stustanet/spacelock/(list of files, cad)

Other CAD files:
mount/parametric_involute_gear_v5.0.scad
