stustanet/spacelock/board_inside/motor-current-measurements/full curve.png

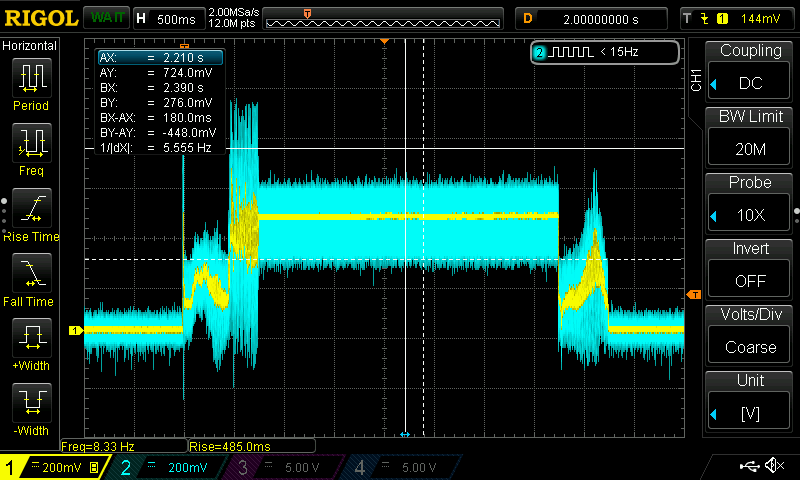
board_inside/motor-current-measurements/full curve.png
