stustanet/spacelock/board_inside/motor-current-measurements/opening.png

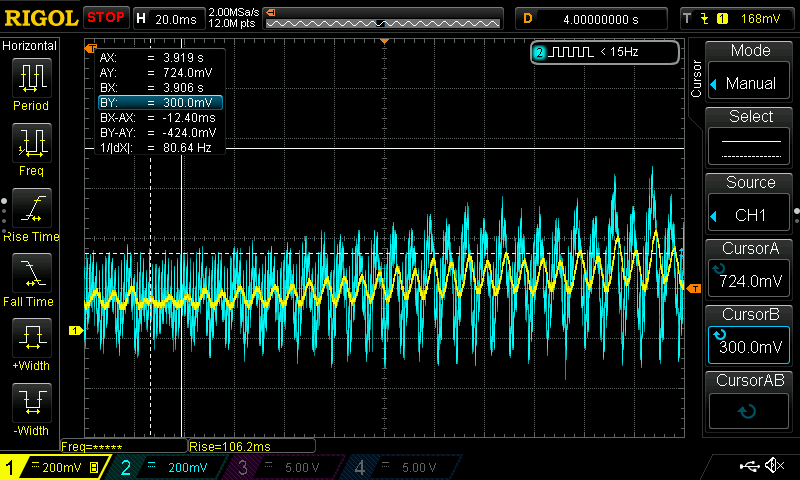
board_inside/motor-current-measurements/opening.png
