stustanet/spacelock/board_inside/motor-current-measurements/start pulse.png

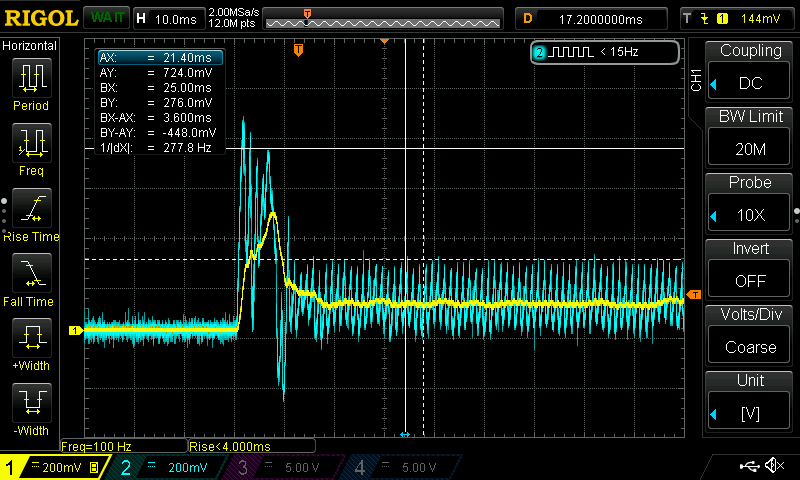
board_inside/motor-current-measurements/start pulse.png
