stustanet/spacelock/board_inside/motor-current-measurements/transition and endstop.png

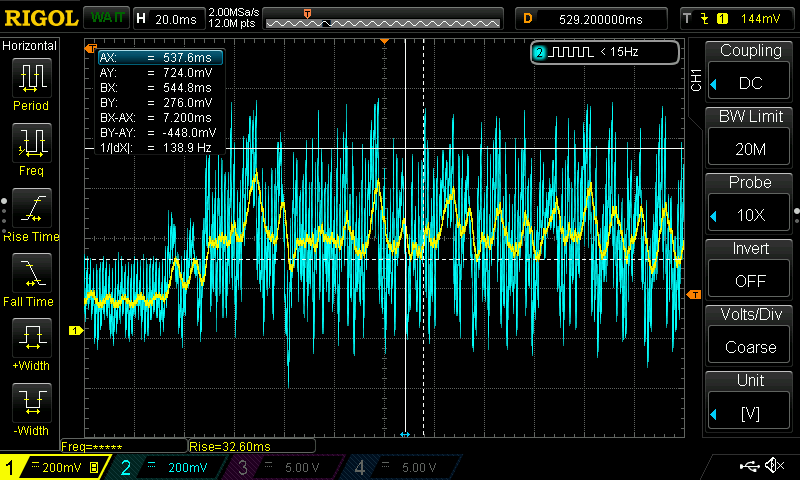
board_inside/motor-current-measurements/transition and endstop.png
