stustanet/spacelock/board_inside/board_v1.1/changes.md

# v1.0 to v1.1
- improve debug connector
- add resistor divider for Vref for motor driver
- add RTC
- add connector for QR-Reader
