stustanet/spacelock/board_inside/board_v1.1/board.kicad_pcb

## KiCad design board_inside/board_v1.1/board.kicad_pcb (2024-01-21)

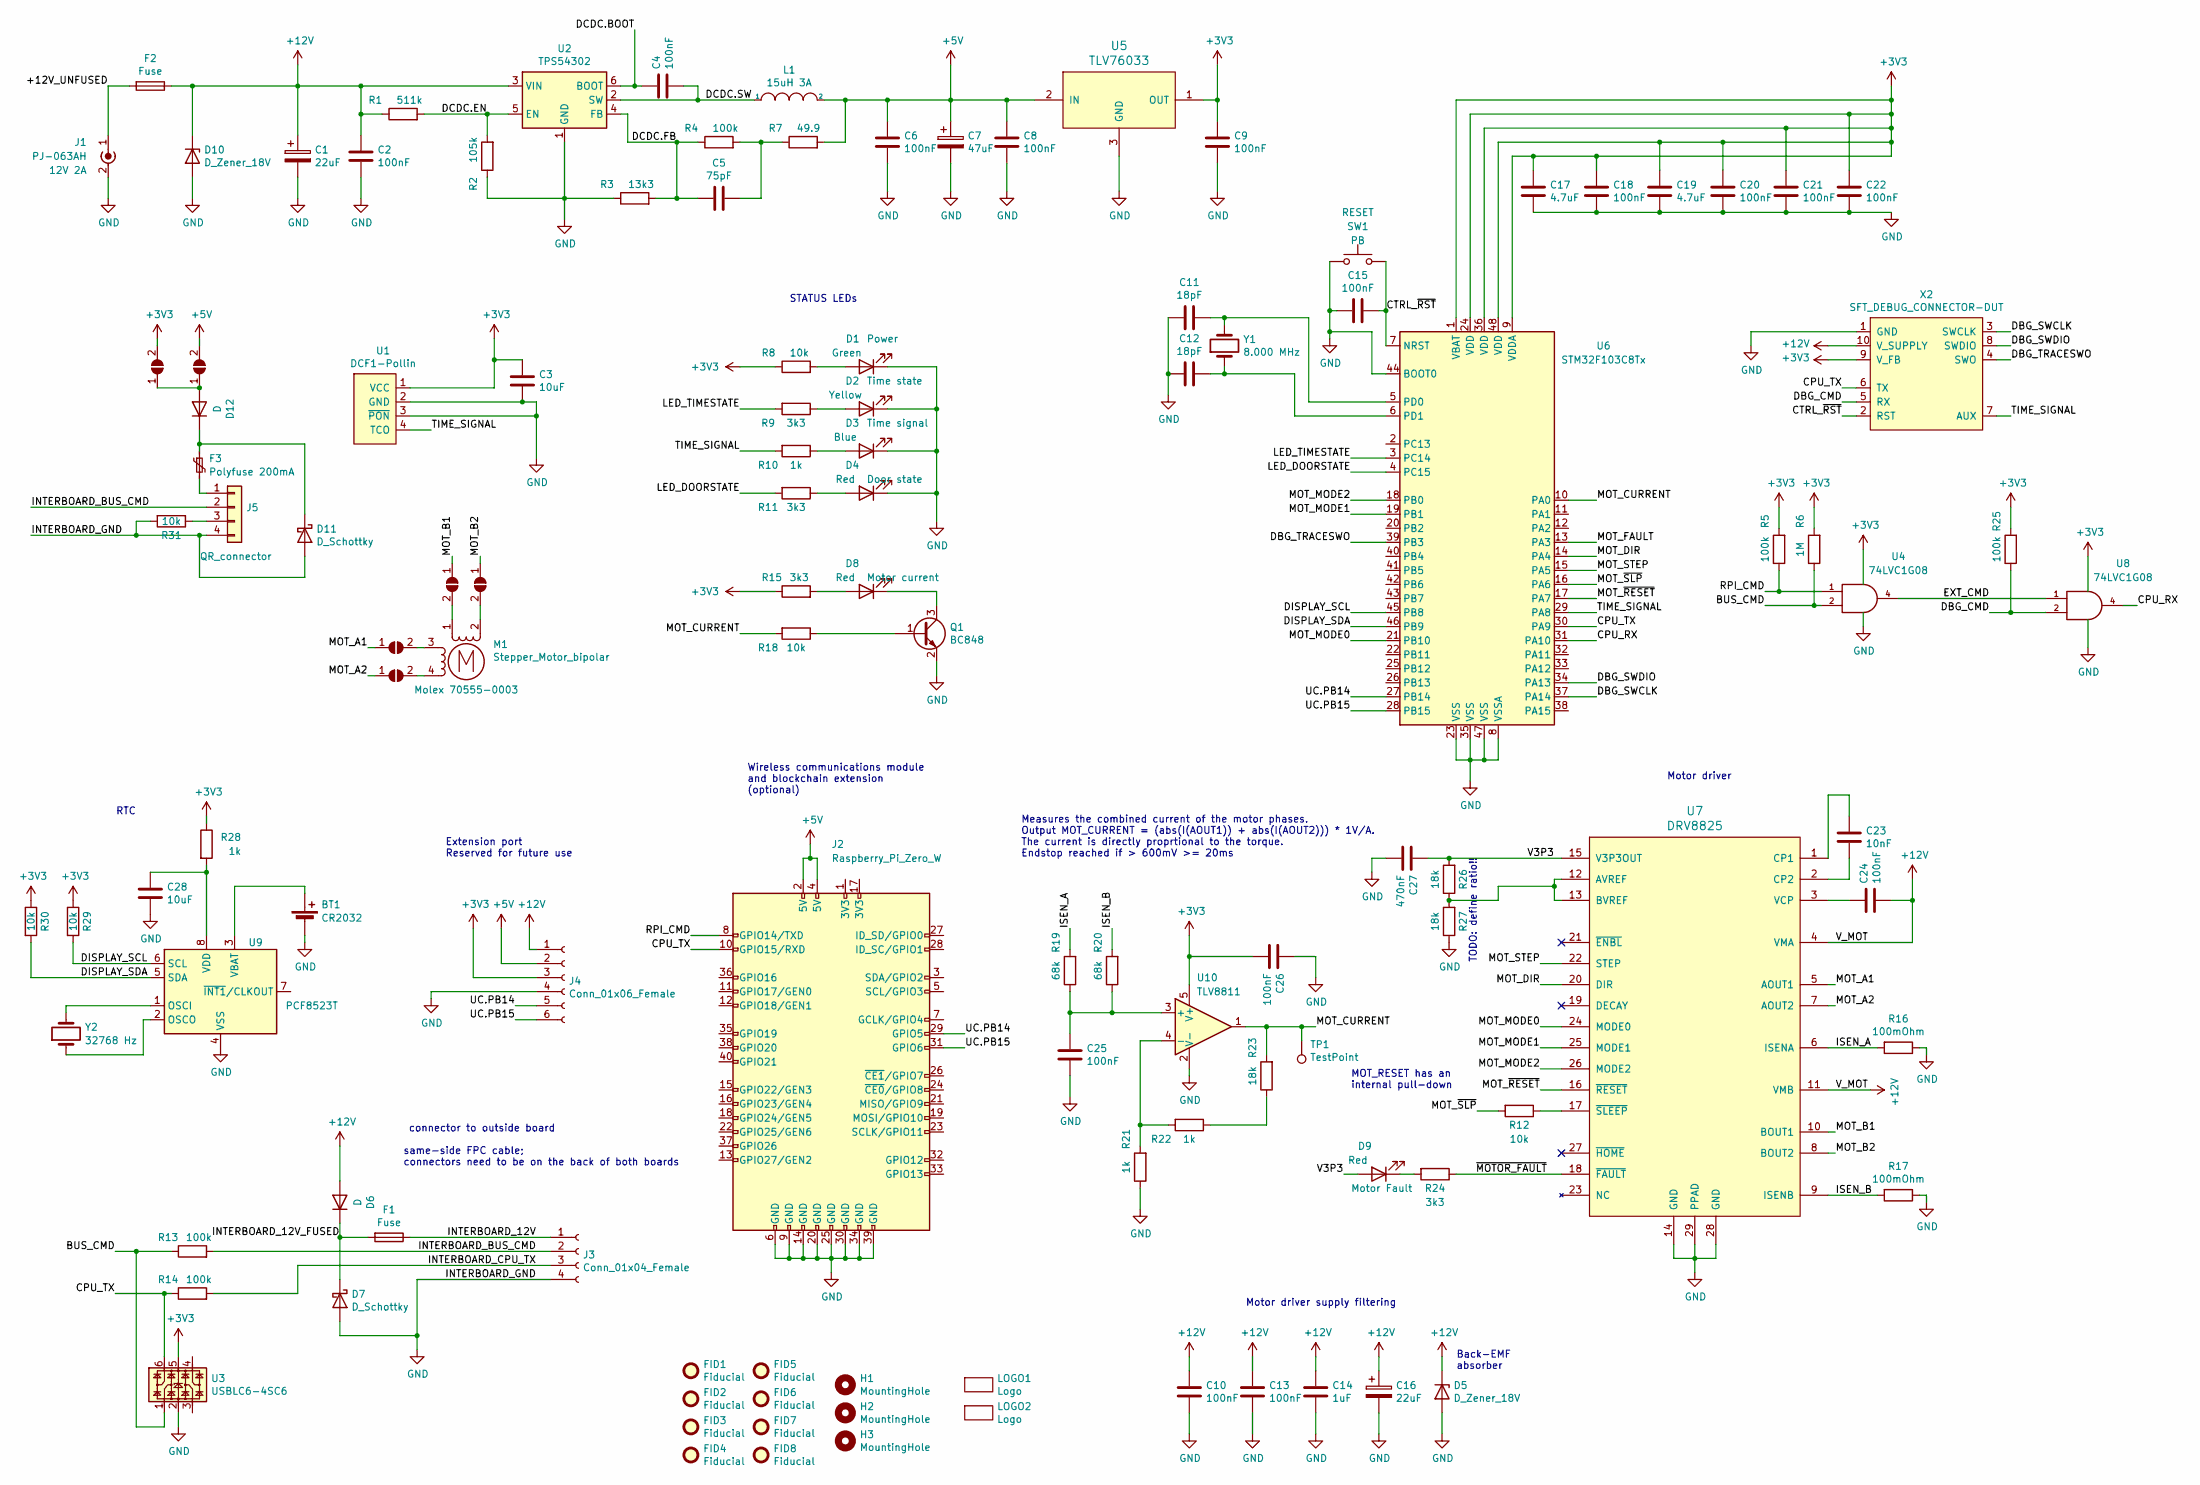
[picture p5: schematic board.kicad_sch, spacelock main board]

Parts:
BT1: CR2032; BatteryHolder_Keystone_3000_1x12mm; MPN Keystone 3000
C1, C16: 22uF; C_1206_3216Metric_Pad1.33x1.80mm_HandSolder; Rating 25V; MPN generic C%f %v %r
C2, C4, C6, C8, C9, C10, C13, C15, C18, C20, C21, C22, C24, C25, C26: 100nF; C_0603_1608Metric_Pad1.08x0.95mm_HandSolder; MPN generic C%f %v %r
C3, C28: 10uF; C_0603_1608Metric_Pad1.08x0.95mm_HandSolder; Rating 6.3V; MPN generic C%f %v %r
C5: 75pF; C_0603_1608Metric_Pad1.08x0.95mm_HandSolder; MPN generic C%f %v %r
C7: 47uF; C_1206_3216Metric_Pad1.33x1.80mm_HandSolder; Rating 6.3V; MPN generic C%f %v %r
C11, C12: 18pF; C_0603_1608Metric_Pad1.08x0.95mm_HandSolder; MPN generic C%f %v %r
C14: 1uF; C_0603_1608Metric_Pad1.08x0.95mm_HandSolder; MPN generic C%f %v %r
C17, C19: 4.7uF; C_0603_1608Metric_Pad1.08x0.95mm_HandSolder; Rating 6.3V; MPN generic C%f %v %r
C23: 10nF; C_0603_1608Metric_Pad1.08x0.95mm_HandSolder; MPN generic C%f %v %r
C27: 470nF; C_0603_1608Metric_Pad1.08x0.95mm_HandSolder; Rating 6.3V; MPN generic C%f %v %r
D1: Green; LED_0805_2012Metric_Pad1.15x1.40mm_HandSolder; MPN Wuerth 150080GS75000
D2: Yellow; LED_0805_2012Metric_Pad1.15x1.40mm_HandSolder; MPN Wuerth 150080YS75000
D3: Blue; LED_0805_2012Metric_Pad1.15x1.40mm_HandSolder; MPN Wuerth 150080BS75000
D4, D8, D9: Red; LED_0805_2012Metric_Pad1.15x1.40mm_HandSolder; MPN Wuerth 150080RS75000
D5, D10: D_Zener_18V; D_MiniMELF_Handsoldering; MPN generic ZMM5248B
D6, D12: D; D_SMB; MPN Rectron HFM208-W
D7, D11: D_Schottky; D_SOD-123; MPN Rectron 2SS100L-W
F1, F2: Fuse; Schurter-OGN-SMD; MPN Schurter OGN SMD
F3: Polyfuse 200mA; R_1210_3225Metric; MPN Littlefuse 1206L020YR
FID1, FID2, FID3, FID4, FID5, FID6, FID7, FID8: Fiducial; Fiducial_1mm_Mask2mm
H1, H2, H3: MountingHole; MountingHole_3.2mm_M3
J1: PJ-063AH; BarrelJack_CUI_PJ-063AH_Horizontal; MPN CUI PJ-063AH
J2: Raspberry_Pi_Zero_W; Raspberry_Pi_Zero_Socketed_THT_FaceDown_MountingHoles
J3: Conn_01x04_Female; Wuerth-686104188622; MPN Wuerth 686104188622
J4: Conn_01x06_Female; PinSocket_1x06_P2.54mm_Vertical
J5: QR_connector; PinHeader_1x04_P2.54mm_Vertical; MPN generic header-2.54mm
JP1, JP2, JP3, JP4, JP5, JP6: SolderJumper_2_Open; SolderJumper-2_P1.3mm_Open_TrianglePad1.0x1.5mm
L1: 15uH 3A; SRN8040TA; MPN Bourns SRN8040TA-150M
LOGO1: Logo; LOGO
LOGO2: Logo; LOGO_CU_070
M1: Stepper_Motor_bipolar; Molex-70555-0003; MPN Molex 70555-0003
Q1: BC848; SOT-23; MPN generic BC848B
R1: 511k; R_0603_1608Metric_Pad0.98x0.95mm_HandSolder; MPN generic R%f %v %r
R2: 105k; R_0603_1608Metric_Pad0.98x0.95mm_HandSolder; MPN generic R%f %v %r
R3: 13k3; R_0603_1608Metric_Pad0.98x0.95mm_HandSolder; MPN generic R%f %v %r
R4, R5, R13, R14, R25: 100k; R_0603_1608Metric_Pad0.98x0.95mm_HandSolder; MPN generic R%f %v %r
R6: 1M; R_0603_1608Metric_Pad0.98x0.95mm_HandSolder; MPN generic R%f %v %r
R7: 49.9; R_0603_1608Metric_Pad0.98x0.95mm_HandSolder; MPN generic R%f %v %r
R8, R12, R18, R29, R30, R31: 10k; R_0603_1608Metric_Pad0.98x0.95mm_HandSolder; MPN generic R%f %v %r
R9, R11, R15, R24: 3k3; R_0603_1608Metric_Pad0.98x0.95mm_HandSolder; MPN generic R%f %v %r
R10, R21, R22, R28: 1k; R_0603_1608Metric_Pad0.98x0.95mm_HandSolder; MPN generic R%f %v %r
R16, R17: 100mOhm; R_2512_6332Metric; MPN Yageo PT2512FK-7W0R1L
R19, R20: 68k; R_0603_1608Metric_Pad0.98x0.95mm_HandSolder; MPN generic R%f %v %r
R23, R26, R27: 18k; R_0603_1608Metric_Pad0.98x0.95mm_HandSolder; MPN generic R%f %v %r
SW1: PB; SW_PUSH_6mm_H4.3mm; MPN Panasonic EVQPAE05R
TP1: TestPoint; TestPoint_Pad_D1.5mm
U1: DCF1-Pollin; MPN Pollin DCF1
U2: TPS54302; SOT-23-6; MPN TI TPS54302DDC
U3: USBLC6-4SC6; SOT-23-6; MPN ST USBLC6-4SC6
U4, U8: 74LVC1G08; SOT-23-5_HandSoldering; MPN TI 74LVC1G08DBV
U5: TLV76033; SOT-23; MPN TI TLV76033DBZ
U6: STM32F103C8Tx; LQFP-48_7x7mm_P0.5mm; MPN ST STM32F103C8T6
U7: DRV8825; HTSSOP-28-1EP_4.4x9.7mm_P0.65mm_EP3.4x9.5mm_ThermalVias; MPN TI DRV8825PWP
U9: PCF8523T; SOIC-8_3.9x4.9mm_P1.27mm; MPN NXP PCF8523T
U10: TLV8811; SOT-23-5_HandSoldering; MPN TI TLV8811DBV
X2: SFT_DEBUG_CONNECTOR-DUT; Tag-Connect_TC2050-IDC-FP_2x05_P1.27mm_Vertical
Y1: 8.000 MHz; Crystal_HC49-U_Vertical; MPN ZheJiang B08000J065
Y2: 32768 Hz; Crystal_SMD_EuroQuartz_EQ161-2Pin_3.2x1.5mm_HandSoldering; MPN MicroCrystal CM7V-T1A-LOW-ESR-32.768KHZ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

Connections:
+3V3: C3.1, C9.1, C17.1, C18.1, C19.1, C20.1, C21.1, C22.1, C26.2, J4.3, JP6.2 (B), R5.2, R6.2, R8.1, R15.1, R25.2, R28.1, R29.1, R30.1, U1.1 (VCC), U3.5, U4.5 (VCC), U5.1 (OUT), U6.1 (VBAT), U6.9 (VDDA), U6.24 (VDD), U6.36 (VDD), U6.48 (VDD), U8.5 (VCC), U10.5 (V+), X2.9 (V_FB)
+5V: C6.1, C7.1, C8.1, J2.2 (5V), J2.4 (5V), J4.2, JP5.2 (B), L1.2, R7.2, U5.2 (IN)
+12V: C1.1, C2.1, C10.1, C13.1, C14.1, C16.1, C24.2, D5.1 (K), D6.2 (A), D10.1 (K), F2.1, J4.1, R1.1, U2.3 (VIN), U7.4 (VMA), U7.11 (VMB), X2.10 (V_SUPPLY)
/+12V_UNFUSED: F2.2, J1.1 (In)
/BUS_CMD: R6.1, R13.1, U3.1, U4.2
/CPU_RX: U6.31 (PA10), U8.4
/CPU_TX: J2.10 (GPIO15/RXD), R14.1, U3.6, U6.30 (PA9), X2.6 (TX)
/CTRL_~RST: C15.1, SW1.2, U6.7 (NRST), X2.2 (RST)
/DBG_CMD: R25.1, U8.2, X2.5 (RX)
/DBG_SWCLK: U6.37 (PA14), X2.3 (SWCLK)
/DBG_SWDIO: U6.34 (PA13), X2.8 (SWDIO)
/DBG_TRACESWO: U6.39 (PB3), X2.4 (SWO)
/DCDC.BOOT: C4.1, U2.6 (BOOT)
/DCDC.EN: R1.2, R2.2, U2.5 (EN)
/DCDC.FB: C5.2, R3.2, R4.1, U2.4 (FB)
/DCDC.SW: C4.2, L1.1, U2.2 (SW)
/DISPLAY_SCL: R29.2, U6.45 (PB8), U9.6 (SCL)
/DISPLAY_SDA: R30.2, U6.46 (PB9), U9.5 (SDA)
/EXT_CMD: U4.4, U8.1
/INTERBOARD_12V: F1.1, J3.1
/INTERBOARD_12V_FUSED: D6.1 (K), D7.1 (K), F1.2
/INTERBOARD_BUS_CMD: J3.2, J5.2, R13.2
/INTERBOARD_CPU_TX: J3.3, R14.2
/ISEN_A: R16.2, R19.2, U7.6 (ISENA)
/ISEN_B: R17.2, R20.2, U7.9 (ISENB)
/LED_DOORSTATE: R11.2, U6.4 (PC15)
/LED_TIMESTATE: R9.2, U6.3 (PC14)
/MOT_A1: JP1.1 (A), U7.5 (AOUT1)
/MOT_A2: JP2.1 (A), U7.7 (AOUT2)
/MOT_B1: JP3.1 (A), U7.10 (BOUT1)
/MOT_B2: JP4.1 (A), U7.8 (BOUT2)
/MOT_CURRENT: R18.2, R23.2, TP1.1, U6.10 (PA0), U10.1
/MOT_DIR: U6.14 (PA4), U7.20 (DIR)
/MOT_FAULT: U6.13 (PA3)
/MOT_MODE0: U6.21 (PB10), U7.24 (MODE0)
/MOT_MODE1: U6.19 (PB1), U7.25 (MODE1)
/MOT_MODE2: U6.18 (PB0), U7.26 (MODE2)
/MOT_STEP: U6.15 (PA5), U7.22 (STEP)
/MOT_~RESET: U6.17 (PA7), U7.16 (~RESET)
/MOT_~SLP: R12.2, U6.16 (PA6)
/RPI_CMD: J2.8 (GPIO14/TXD), R5.1, U4.1
/TIME_SIGNAL: R10.2, U1.4 (TCO), U6.29 (PA8), X2.7 (AUX)
/UC.PB14: J2.29 (GPIO5), J4.5, U6.27 (PB14)
/UC.PB15: J2.31 (GPIO6), J4.6, U6.28 (PB15)
/V3P3: C27.1, D9.2 (A), R26.2, U7.15 (V3P3OUT)
/~MOTOR_FAULT: R24.1, U7.18 (~FAULT)
GND: BT1.2 (-), C1.2, C2.2, C3.2, C6.2, C7.2, C8.2, C9.2, C10.2, C11.2, C12.2, C13.2, C14.2, C15.2, C16.2, C17.2, C18.2, C19.2, C20.2, C21.2, C22.2, C25.2, C26.1, C27.2, C28.2, D1.1 (K), D2.1 (K), D3.1 (K), D4.1 (K), D5.2 (A), D7.2 (A), D10.2 (A), D11.2 (A), J1.2 (Ext), J2.6 (GND), J2.9 (GND), J2.14 (GND), J2.20 (GND), J2.25 (GND), J2.30 (GND), J2.34 (GND), J2.39 (GND), J3.4, J4.4, J5.4, Q1.2 (E), R2.1, R3.1, R16.1, R17.1, R21.1, R27.1, R31.2, SW1.1, U1.2 (GND), U1.3 (~PON), U2.1 (GND), U3.2, U4.3 (GND), U5.3 (GND), U6.8 (VSSA), U6.23 (VSS), U6.35 (VSS), U6.44 (BOOT0), U6.47 (VSS), U7.14 (GND), U7.28 (GND), U7.29 (PPAD), U8.3 (GND), U9.4 (VSS), U10.2 (V-), X2.1 (GND)
unnamed: BT1.1 (+), U9.3 (VBAT)
unnamed: C5.1, R4.2, R7.1
unnamed: D1.2 (A), R8.2
unnamed: D2.2 (A), R9.1
unnamed: D3.2 (A), R10.1
unnamed: D4.2 (A), R11.1
unnamed: D8.2 (A), R15.2
unnamed: D8.1 (K), Q1.3 (C)
unnamed: D9.1 (K), R24.2
unnamed: D11.1 (K), D12.1 (K), F3.1
unnamed: D12.2 (A), JP5.1 (A), JP6.1 (A)
unnamed: F3.2, J5.1
unnamed: J5.3, R31.1
unnamed: JP1.2 (B), M1.3
unnamed: JP2.2 (B), M1.4
unnamed: JP3.2 (B), M1.1
unnamed: JP4.2 (B), M1.2 (-)
unnamed: Q1.1 (B), R18.1
unnamed: R22.1, R23.1
unnamed: C11.1, U6.5 (PD0), Y1.2
unnamed: C12.1, U6.6 (PD1), Y1.1
unnamed: R26.1, R27.2, U7.12 (AVREF), U7.13 (BVREF)
unnamed: C23.1, U7.1 (CP1)
unnamed: C23.2, U7.2 (CP2)
unnamed: C24.1, U7.3 (VCP)
unnamed: R12.1, U7.17 (~SLEEP)
unnamed: U9.1 (OSCI), Y2.2
unnamed: U9.2 (OSCO), Y2.1
unnamed: C28.1, R28.2, U9.8 (VDD)
unnamed: C25.1, R19.1, R20.1, U10.3 (+)
unnamed: R21.2, R22.2, U10.4 (-)

Notes on the sheet:
Measures the combined current of the motor phases. Output MOT_CURRENT = (abs(I(AOUT1)) + abs(I(AOUT2))) * 1V/A. The current is directly proprtional to the torque. Endstop reached if > 600mV >= 20ms
MOT_RESET has an internal pull-down
Back-EMF absorber
Extension port Reserved for future use
Motor driver supply filtering
STATUS LEDs
RTC
Wireless communications module and blockchain extension (optional)
Motor driver
TODO: define ratio!!
connector to outside board same-side FPC cable; connectors need to be on the back of both boards

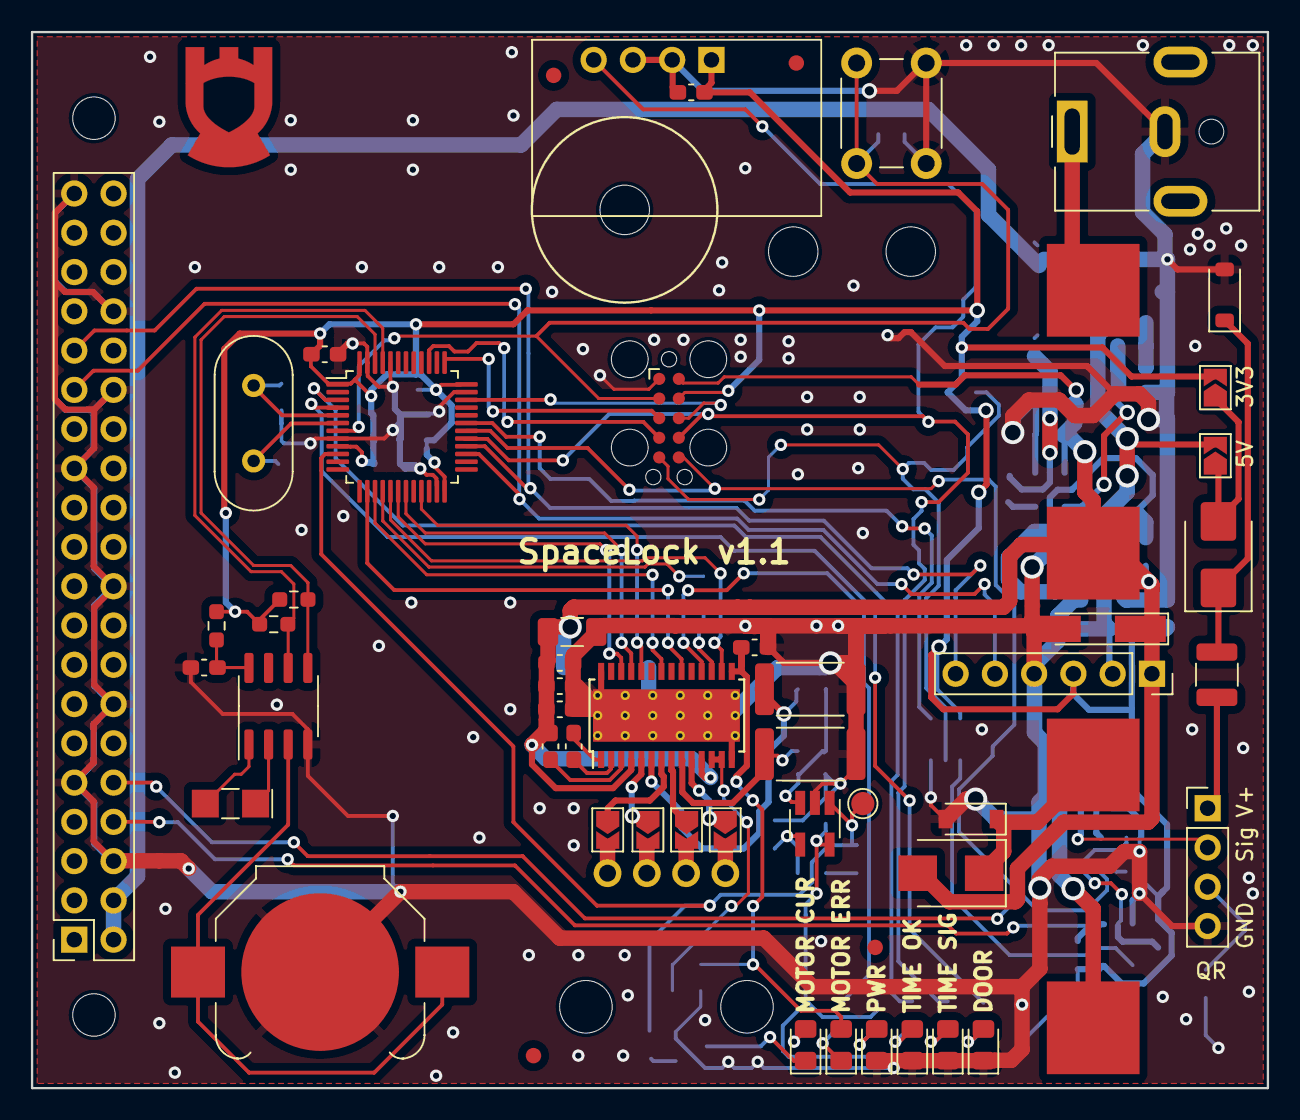
[picture p6: board board_inside/board_v1.1/board.kicad_pcb from above]

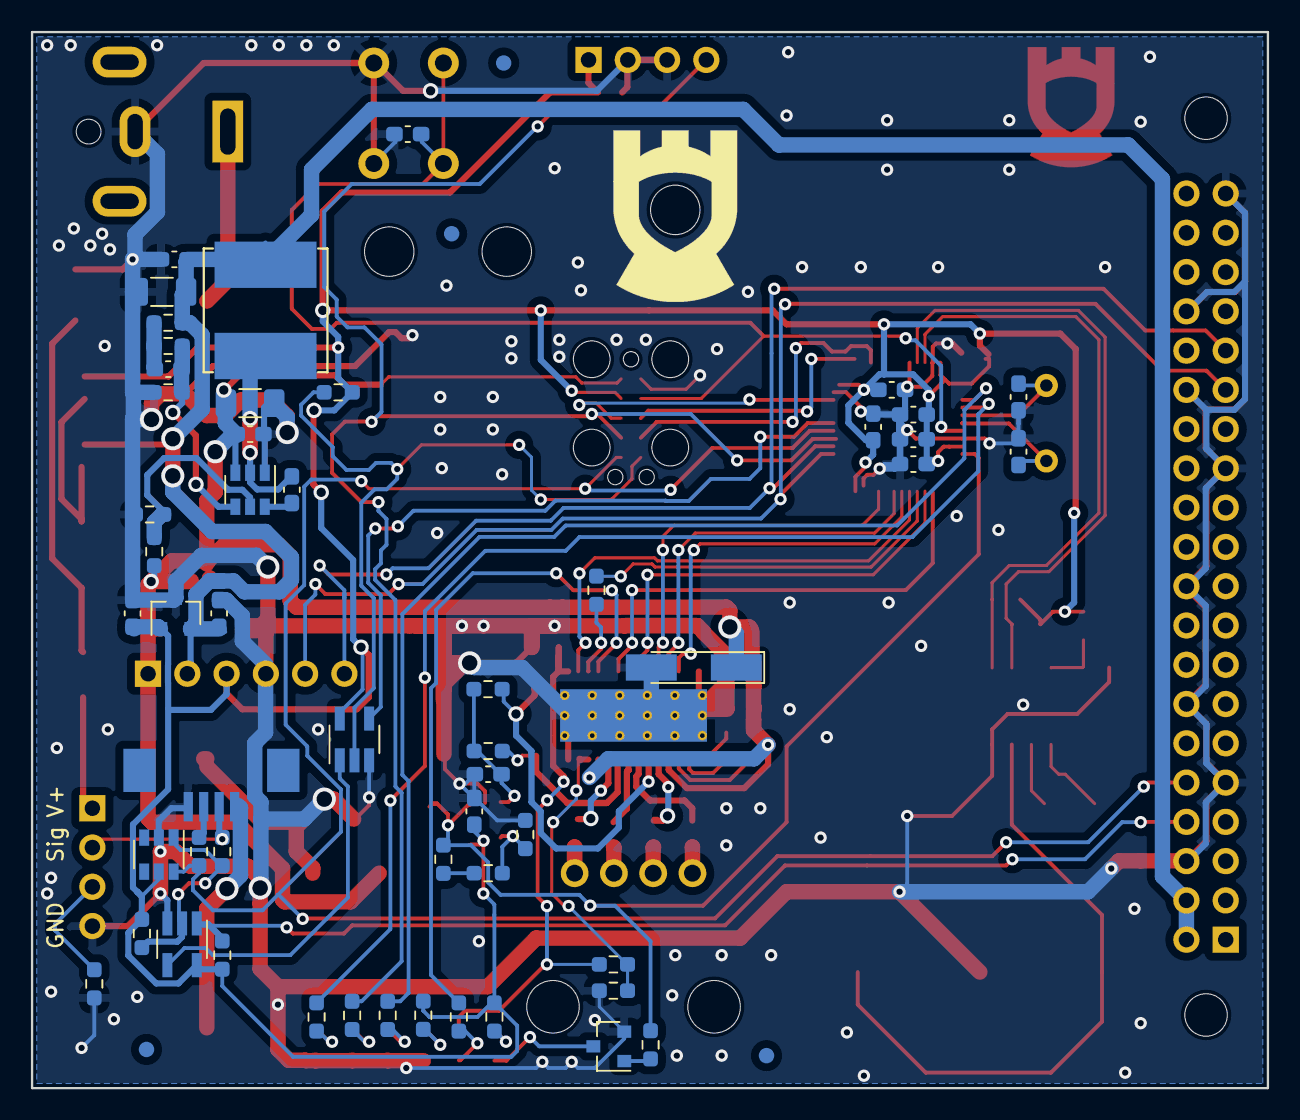
[picture p7: board board_inside/board_v1.1/board.kicad_pcb from below]

Board: 2 copper layers, 79.9 x 68.3 mm, 117 parts (58 on the bottom side), 77 nets.
