stustanet/spacelock/board_outside/board_v1/board.kicad_pcb

## KiCad design board_outside/board_v1/board.kicad_pcb (2023-06-20, an earlier design)

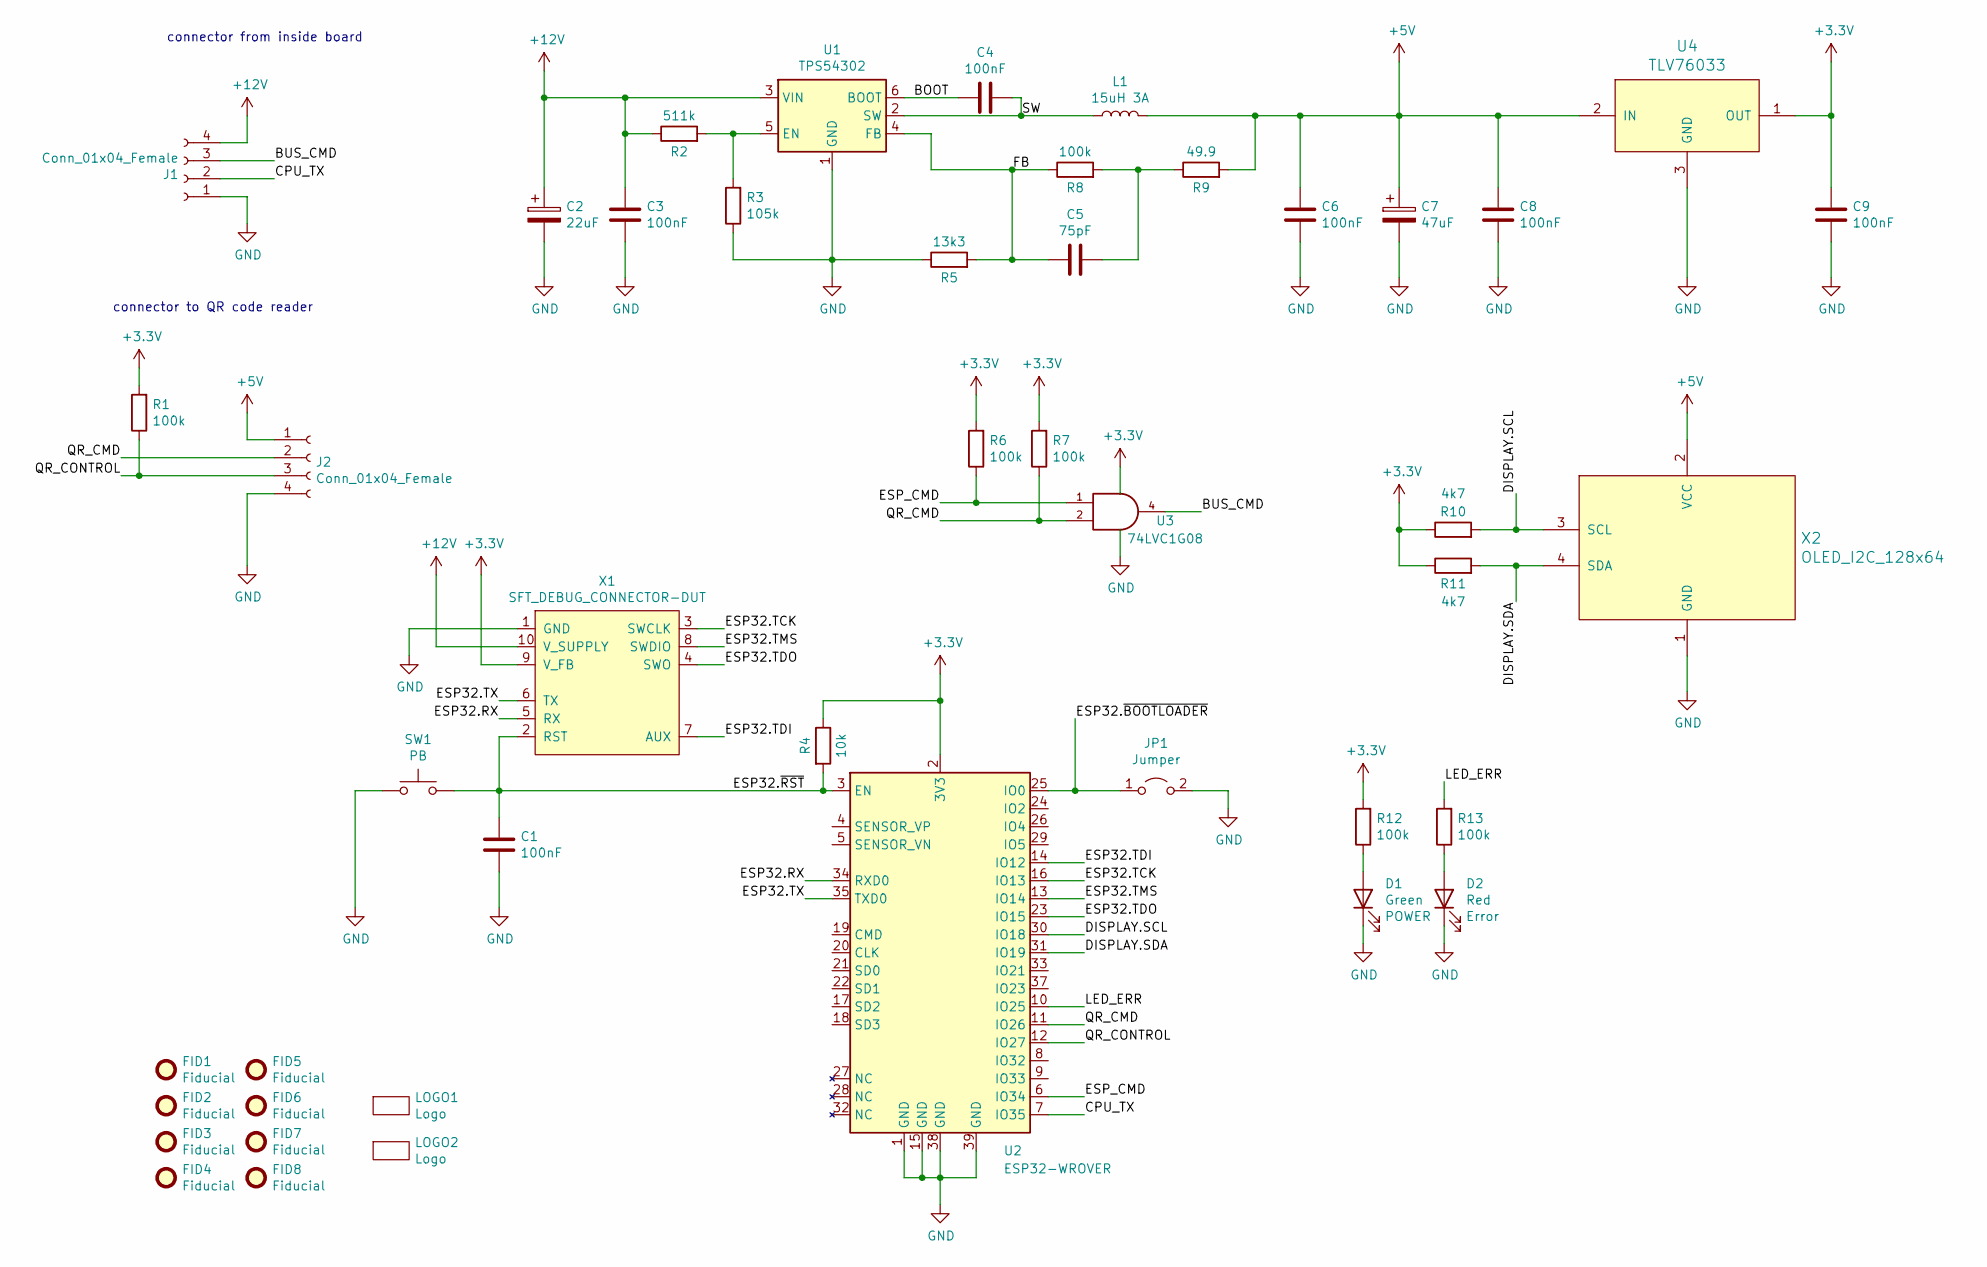
[picture p8: schematic board.kicad_sch]

Parts:
C1, C3, C4, C6, C8, C9: 100nF; C_0603_1608Metric_Pad1.08x0.95mm_HandSolder; MPN generic C%f %v %r
C2: 22uF; C_1206_3216Metric_Pad1.33x1.80mm_HandSolder; Rating 25V; MPN generic C%f %v %r
C5: 75pF; C_0603_1608Metric_Pad1.08x0.95mm_HandSolder; MPN generic C%f %v %r
C7: 47uF; C_1206_3216Metric_Pad1.33x1.80mm_HandSolder; Rating 6.3V; MPN generic C%f %v %r
D1: Green; LED_0805_2012Metric_Pad1.15x1.40mm_HandSolder; MPN Wuerth 150080GS75000
D2: Red; LED_0805_2012Metric_Pad1.15x1.40mm_HandSolder; MPN Wuerth 150080RS75000
FID1, FID2, FID3, FID4, FID5, FID6, FID7, FID8: Fiducial; Fiducial_1mm_Mask2mm
J1: Conn_01x04_Female; Wuerth-686104188622; MPN Wuerth 686104188622
J2: Conn_01x04_Female; PinSocket_1x04_P2.54mm_Vertical; MPN generic header-2.54mm
JP1: Jumper; PinHeader_1x02_P2.54mm_Vertical
L1: 15uH 3A; SRN8040TA; MPN Bourns SRN8040TA-150M
LOGO1: Logo; LOGO_CU_070
LOGO2: Logo; LOGO
R1, R6, R7, R8, R12, R13: 100k; R_0603_1608Metric_Pad0.98x0.95mm_HandSolder; MPN generic R%f %v %r
R2: 511k; R_0603_1608Metric_Pad0.98x0.95mm_HandSolder; MPN generic R%f %v %r
R3: 105k; R_0603_1608Metric_Pad0.98x0.95mm_HandSolder; MPN generic R%f %v %r
R4: 10k; R_0603_1608Metric_Pad0.98x0.95mm_HandSolder; MPN generic R%f %v %r
R5: 13k3; R_0603_1608Metric_Pad0.98x0.95mm_HandSolder; MPN generic R%f %v %r
R9: 49.9; R_0603_1608Metric_Pad0.98x0.95mm_HandSolder; MPN generic R%f %v %r
R10, R11: 4k7; R_0603_1608Metric_Pad0.98x0.95mm_HandSolder; MPN generic R%f %v %r
SW1: PB; SW_PUSH_6mm_H4.3mm; MPN Panasonic EVQPAE05R
U1: TPS54302; SOT-23-6; MPN TI TPS54302DDC
U2: ESP32-WROVER; MPN Espressif ESP32-WROVER
U3: 74LVC1G08; SOT-23-5_HandSoldering; MPN TI 74LVC1G08DBV
U4: TLV76033; SOT-23; MPN TI TLV76033DBZ
X1: SFT_DEBUG_CONNECTOR-DUT; Tag-Connect_TC2050-IDC-FP_2x05_P1.27mm_Vertical
X2: OLED_I2C_128x64; OLED_128x64_096in; MPN generic I2C-OLED-128x64

Connections:
+3V3: C9.1, R1.2, R4.1, R6.2, R7.2, R10.1, R11.1, R12.2, U2.2 (3V3), U3.5 (VCC), U4.1 (OUT), X1.9 (V_FB)
+5V: C6.1, C7.1, C8.1, J2.1, L1.2, R9.2, U4.2 (IN), X2.2 (VCC)
+12V: C2.1, C3.1, J1.4, R2.1, U1.3 (VIN), X1.10 (V_SUPPLY)
/BOOT: C4.2, U1.6 (BOOT)
/BUS_CMD: J1.3, U3.4
/CPU_TX: J1.2, U2.7 (IO35)
/DISPLAY.SCL: R10.2, U2.30 (IO18), X2.3 (SCL)
/DISPLAY.SDA: R11.2, U2.31 (IO19), X2.4 (SDA)
/ESP32.RX: U2.34 (RXD0), X1.5 (RX)
/ESP32.TCK: U2.16 (IO13), X1.3 (SWCLK)
/ESP32.TDI: U2.14 (IO12), X1.7 (AUX)
/ESP32.TDO: U2.23 (IO15), X1.4 (SWO)
/ESP32.TMS: U2.13 (IO14), X1.8 (SWDIO)
/ESP32.TX: U2.35 (TXD0), X1.6 (TX)
/ESP32.~BOOTLOADER: JP1.1 (A), U2.25 (IO0)
/ESP32.~RST: C1.1, R4.2, SW1.2, U2.3 (EN), X1.2 (RST)
/ESP_CMD: R6.1, U2.6 (IO34), U3.1
/FB: C5.2, R5.2, R8.1, U1.4 (FB)
/LED_ERR: R13.2, U2.10 (IO25)
/QR_CMD: J2.2, R7.1, U2.11 (IO26), U3.2
/QR_CONTROL: J2.3, R1.1, U2.12 (IO27)
/SW: C4.1, L1.1, U1.2 (SW)
GND: C1.2, C2.2, C3.2, C6.2, C7.2, C8.2, C9.2, D1.1 (K), D2.1 (K), J1.1, J2.4, JP1.2 (B), R3.1, R5.1, SW1.1, U1.1 (GND), U2.1 (GND), U2.15 (GND), U2.38 (GND), U2.39 (GND), U3.3 (GND), U4.3 (GND), X1.1 (GND), X2.1 (GND)
unnamed: C5.1, R8.2, R9.1
unnamed: D1.2 (A), R12.1
unnamed: D2.2 (A), R13.1
unnamed: R2.2, R3.2, U1.5 (EN)

Notes on the sheet:
connector to QR code reader
connector from inside board

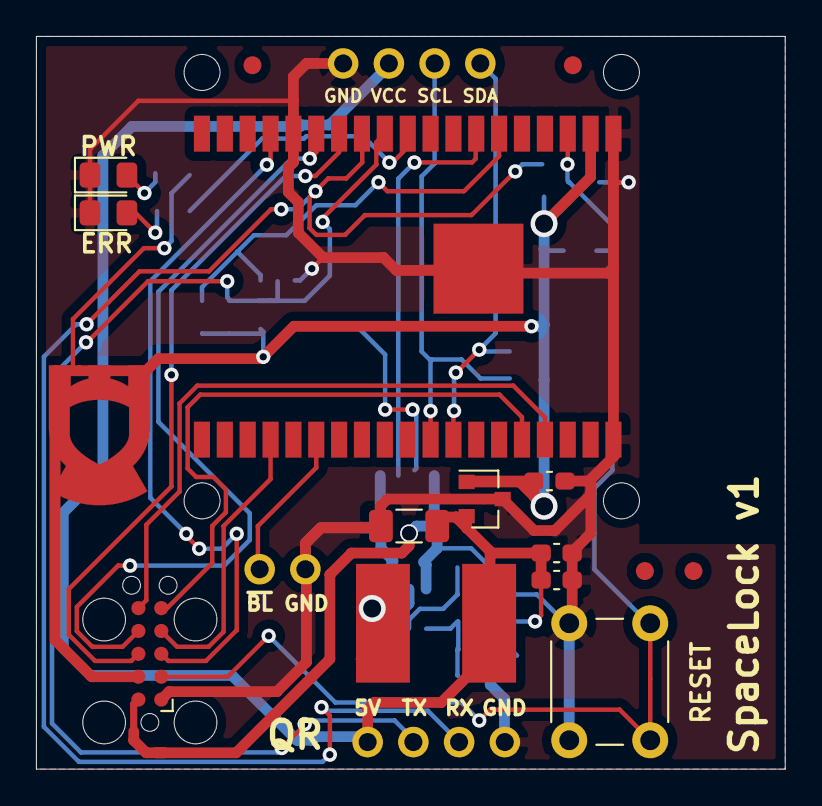
[picture p9: board board_outside/board_v1/board.kicad_pcb from above]

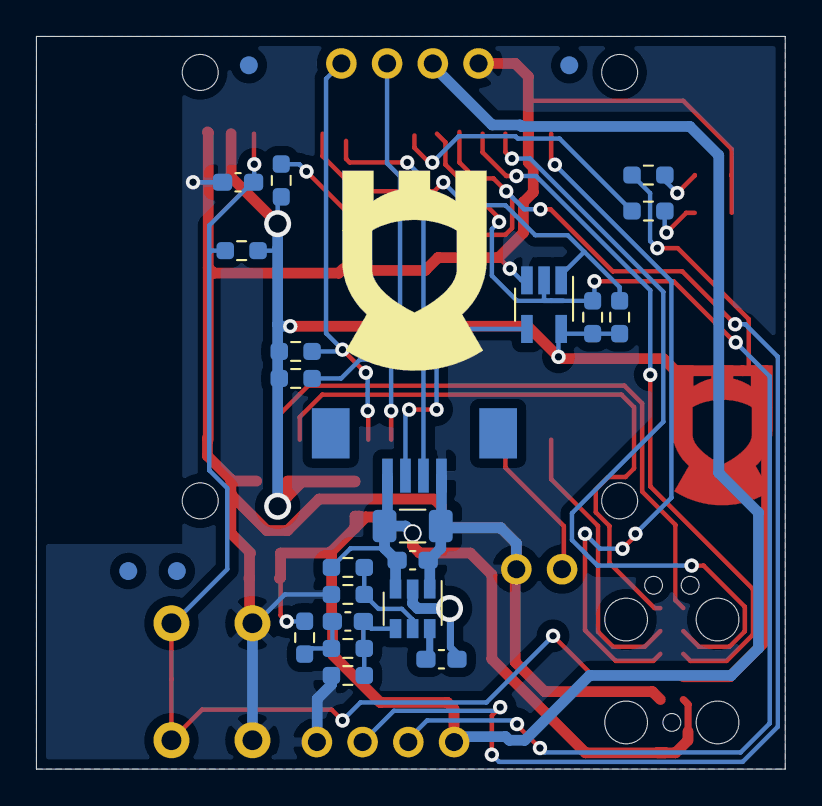
[picture p10: board board_outside/board_v1/board.kicad_pcb from below]

Board: 2 copper layers, 41.6 x 40.7 mm, 45 parts (26 on the bottom side), 27 nets.
