stustanet/spacelock/firmware/src/dcf77.cpp

#include "dcf77.h"

#include <bitset>

#include "dcf77_analyze.h"
#include "gregorian_calendar.h"
#include "hardware.h"
#include "interrupts.h"
#include "time.h"

static void dcf77_update();

// the bits that were received this minute
// a normal minute has 59 bits, but minutes where a leap second is inserted
// have 60 bits.
static std::bitset<60> rx_bits;
static uint8_t rx_bitcount = 0;
static InputPin *input_pin;
static OutputPin *error_pin;
static bool last_input = false;
static uint32_t last_input_time;
static uint64_t last_good_minute_timestamp = 0x8000000000000000ULL;

void dcf77_init(InputPin *pin, OutputPin *error_led) {
    input_pin = pin;
    error_pin = error_led;
    last_input_time = time_get_64();
    add_systick_callback(dcf77_update);
}

static void dcf77_update() {
    uint64_t monotonic_time = time_get_64_isr();
    if (static_cast<uint64_t>(monotonic_time - last_good_minute_timestamp) > 3600000000) {
        error_pin->reset();
    } else {
        error_pin->set();
    }

    bool input = input_pin->get();
    if (input == last_input) { return; }
    last_input = input;

    uint32_t time_delta = static_cast<uint32_t>(monotonic_time) - last_input_time;
    last_input_time = static_cast<uint32_t>(monotonic_time);

    if (input) {
        // Rising edge; analyze length of the negative duty cycle:
        //
        //  0.7s - 1.0s: regular second
        //  1.7s - 2.0s: start of new minute

        if ((time_delta > 700000) && (time_delta <= 1000000)) {
            // It was just a regular second; everything is alright.
        } else if ((time_delta >= 1700000) && (time_delta <= 2000000)) {
            // Alright; this minute is done.
            // Time to pass the accumulated bits on for analyzing.
            // (this includes checking whether there are any/the
            //  right number of bits and whether they make the
            //  tiniest bit of sense).
            uint64_t unix_timestamp;
            if (dcf77_analyze(rx_bits, rx_bitcount, unix_timestamp)) {
                set_timestamp(monotonic_time, unix_timestamp);
                last_good_minute_timestamp = monotonic_time;
                uart_writeline("DCF77: Analysis OK, timestamp 0x", &unix_timestamp);
            }
            else
            {
                uart_writeline("DCF77: Analysis failed");
            }
            rx_bitcount = 0;
        } else {
            // This is an illegal duty cycle; the signal has
            // been corrupted.

            // Better luck next minute.
            rx_bitcount = 0;
        }
    } else {
        // Falling edge (bit has been received).
        if (rx_bitcount > 60) {
            // Something is awfully wrong here. Maybe we missed
            // the minute-end marker.

            // discard the received bits.
            rx_bitcount = 0;
        }

        // Analyze length of the positive duty cycle:
        //
        //  0.07s - 0.13s: bit 0
        //  0.17s - 0.23s: bit 1

        if ((time_delta >= 30000) && (time_delta <= 135000)) {
            // We have received a "0" bit.
            rx_bits[rx_bitcount++] = 0;
        } else if ((time_delta >= 140000) && (time_delta <= 260000)) {
            // We have received a "1" bit.
            rx_bits[rx_bitcount++] = 1;
        } else {
            // Illegal positive duty cycle length; the signal is
            // corrupted.
            //
            // Better luck next minute.
            rx_bitcount = 0;
        }
    }
}
