stustanet/spacelock/firmware/src/time.h

#pragma once

#include <cstdint>

#ifndef __cplusplus
#error lolnope
#endif

void sleep_us(uint64_t duration_us);
void sleep_until_us(uint64_t timestamp_us);

class Period {
public:
    Period(uint64_t period_us);
    void wait_next();

private:
    uint64_t start;
    uint64_t period_us;
};

/** returns the UNIX time, as synchronized through set_timestamp(). */
uint64_t get_timestamp();

/** sets a new UNIX time from an external time source, valid at monotonic_timestamp */
void set_timestamp(uint64_t monotonic_timestamp, uint64_t unix_timestamp);
