stustanet/spacelock/(commit log)

2019-05-07 lololo für jj <3
    [bluepill.cfg]
2019-06-09 implement leds
2019-06-09 add board and mount directories
2019-11-17 initial schematic stuff for board
    [spacelock.kicad_pcb, spacelock.sch]
2020-09-06 board: main connectivity
    [spacelock.kicad_pcb, spacelock.sch]
2021-01-11 Update board
    [board.kicad_pcb, board.sch, spacelock.kicad_pcb, spacelock.sch]
2022-04-03 Add reload button to generate a new code
2022-12-18 flush after printing postgres error
2023-06-20 Port board files to kicad v6
    [board-B_Cu.gbr, board-B_Mask.gbr, board-B_Paste.gbr, board-B_SilkS.gbr, board-Edge_Cuts.gbr, board-F_Cu.gbr, board-F_Mask.gbr, board-F_Paste.gbr]
2023-06-20 Port firmware to board_v1
2023-06-20 feat: sample adc and write out on uart
2023-06-20 feat: parser for uart data to csv
2023-06-20 feat: Current-based end-stop detection
2023-06-20 fix: Adapt parameters for actual door
    [cpp_main.cpp, hardware.cpp]
2023-06-20 Fix board schematic and documentation after initial commissioning
    [board.kicad_sch]
2023-06-20 Disable backdoor and key reset-on-reset
    [cpp_main.cpp]
2023-06-20 process_data.py: Improved debug prints for connection setup
2023-06-20 fix: type for time information
    [hardware.cpp]
2023-06-20 Add reset_secret_key() function for use from gdb
    [cpp_main.cpp]
2024-01-21 inner board v1.1, rtc, QR-connector
    [board.kicad_pcb, board.kicad_sch]
2024-01-21 board v1.1: clean up, create own folder
    [board.kicad_pcb, board.kicad_sch, spacelock_inside_v1.kicad_pcb]
2024-02-05 add door mounting cad model
    [doormount.scad, parametric_involute_gear_v5.0.scad]
